rkopka42/StepTimer/Step01.jpg

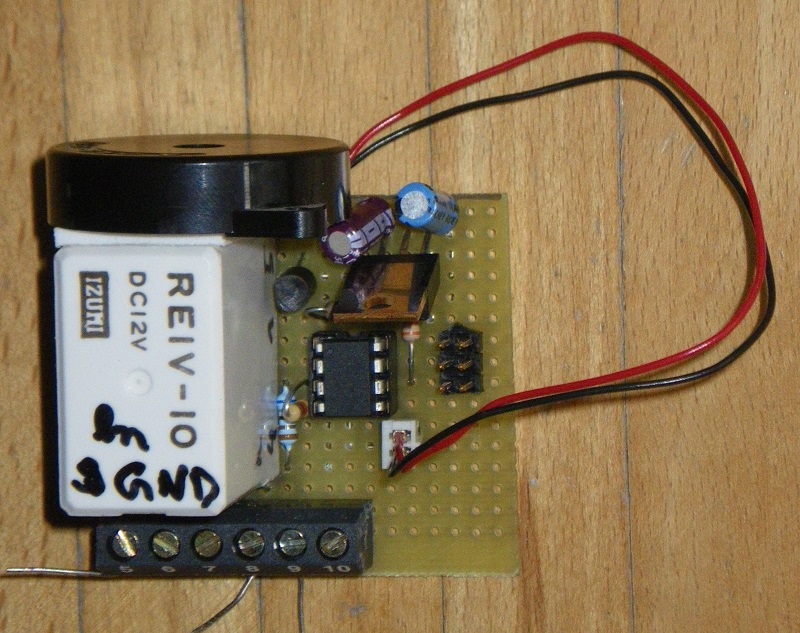
Step01.jpg
