rkopka42/StepTimer/Step02.jpg

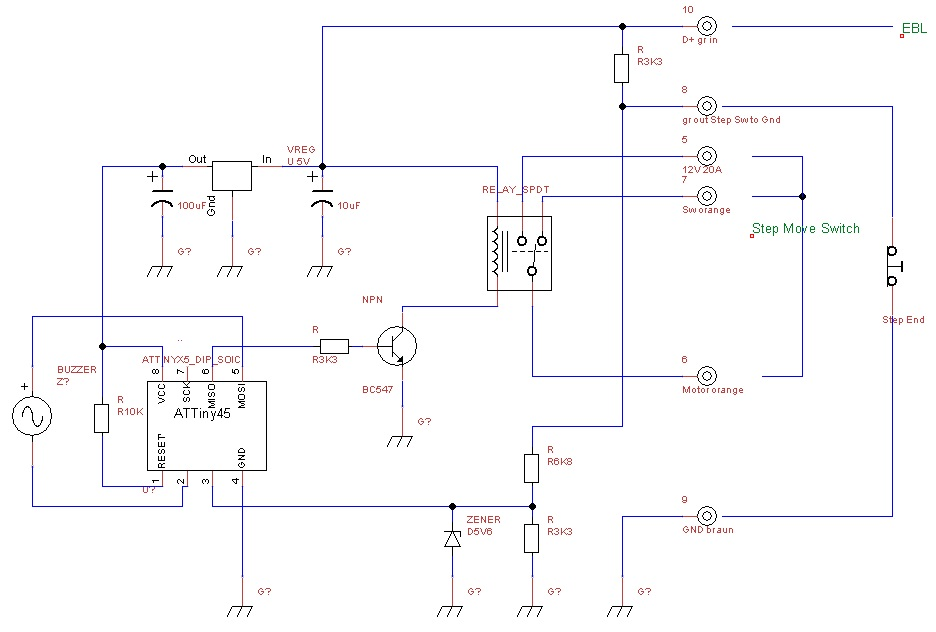
Step02.jpg
