rkopka42/StepTimer/(threads)

Thread 1 (2020-01-20):

Make an Arduino Version

rkopka42, 2020-01-20:
Not really needed, just for compatibility. Will probably be bigger binary code.
Try to do IRQ functionality in a standard loop() like with TL011. Beeps with PWM functions.

rkopka42, 2020-01-26:
Done. PWM version is larger, but better readable and configurable.

Closed 2020-01-26.
